PotatoSmile/custom-flightsim-control-panel-v1/photos/IMG_0789.jpg

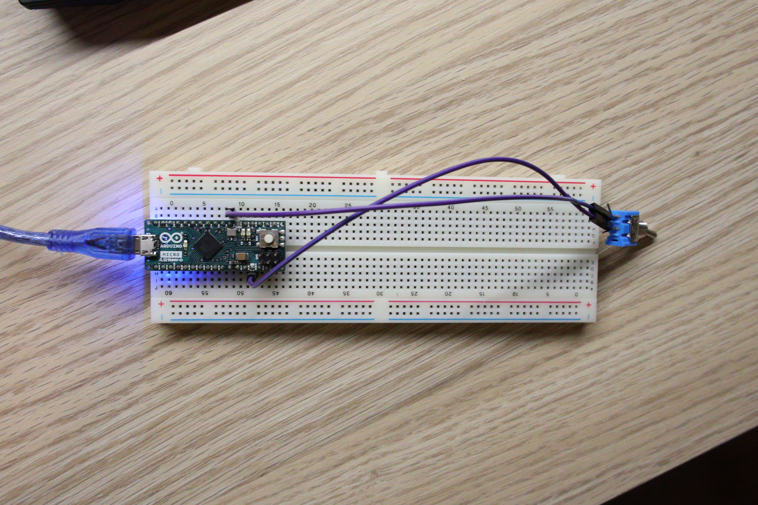
photos/IMG_0789.jpg
