PotatoSmile/custom-flightsim-control-panel-v1/photos/IMG_0802.jpg

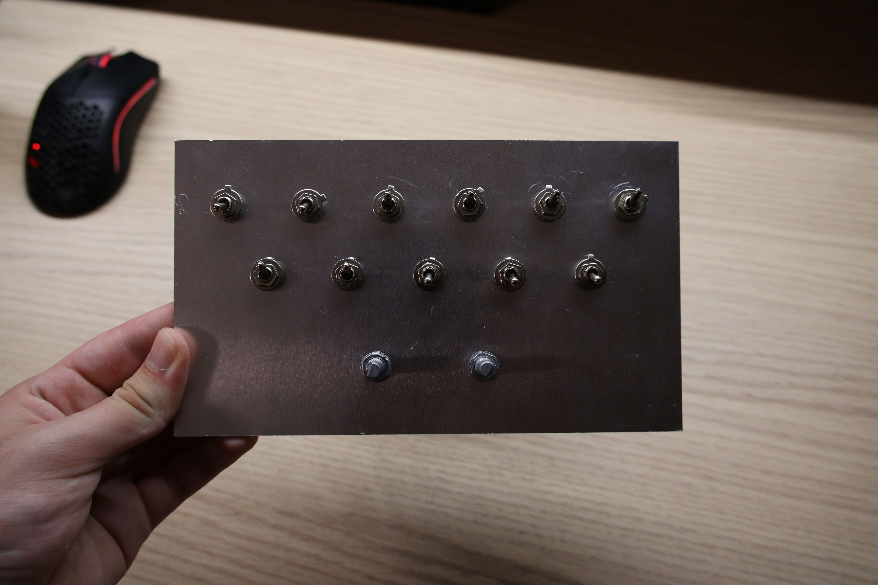
photos/IMG_0802.jpg
