PotatoSmile/custom-flightsim-control-panel-v1/README.md

# custom-flightsim-control-panel

DIY USB switch panel for DCS World, built on an Arduino Micro.
