PotatoSmile/custom-flightsim-control-panel-v1/photos/IMG_0787.jpg

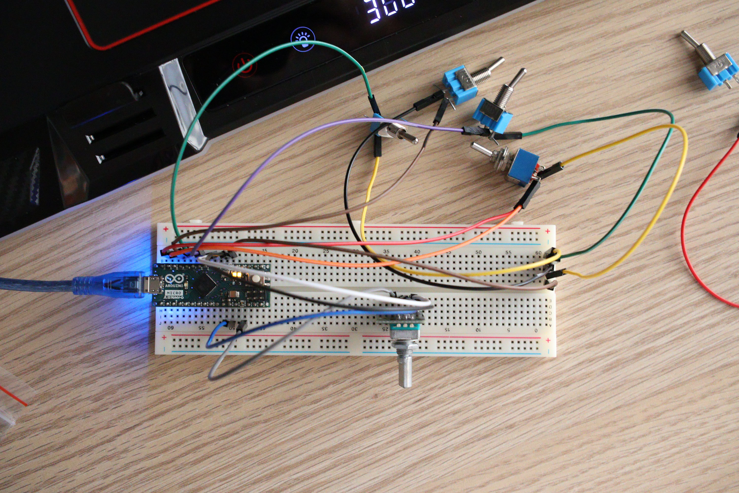
photos/IMG_0787.jpg
