PotatoSmile/custom-flightsim-control-panel-v1/photos/IMG_0793.jpg

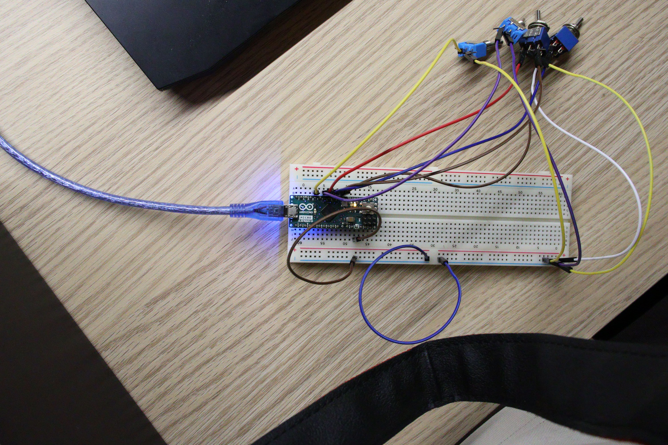
photos/IMG_0793.jpg
