PotatoSmile/custom-flightsim-control-panel-v1/photos/IMG_0794.jpg

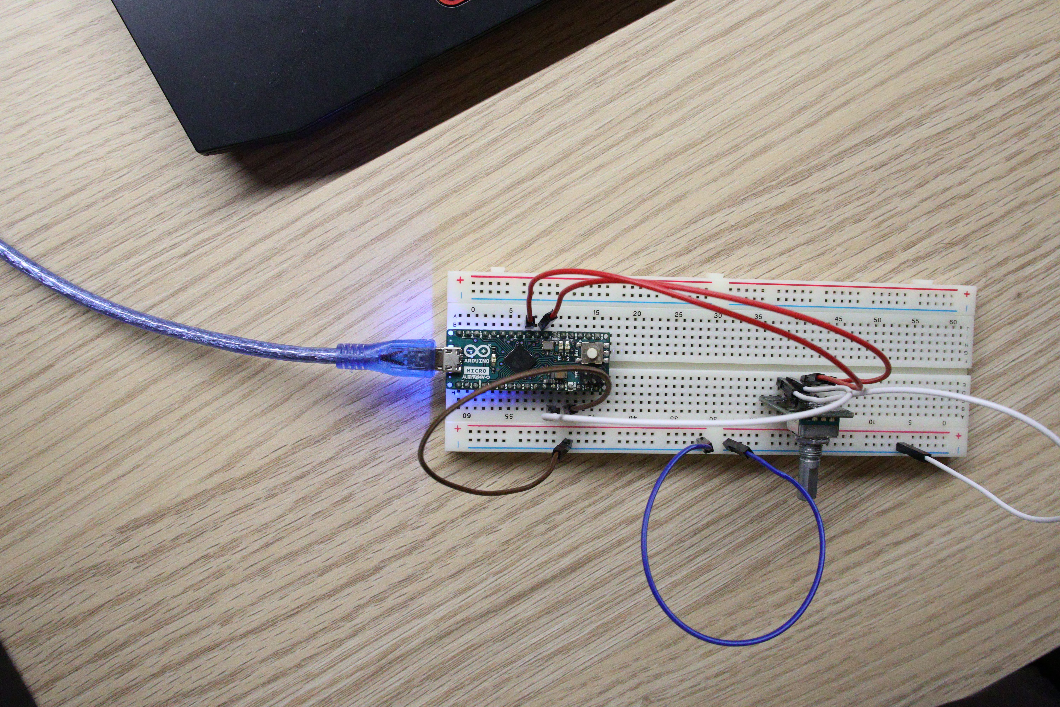
photos/IMG_0794.jpg
