PotatoSmile/custom-flightsim-control-panel-v1/photos/IMG_0796.jpg

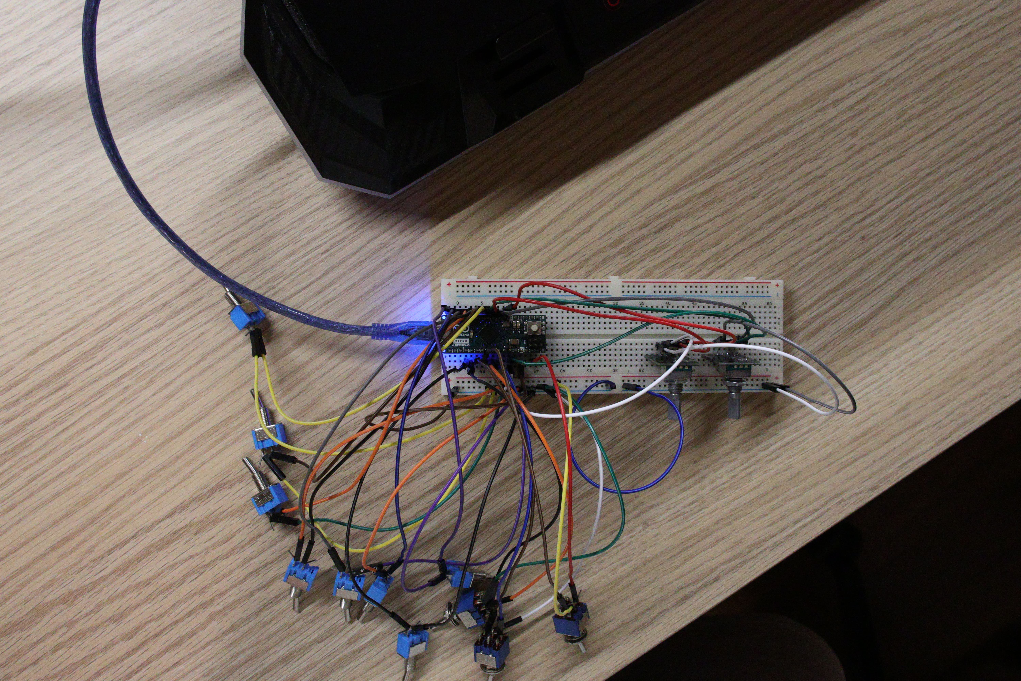
photos/IMG_0796.jpg
