PotatoSmile/custom-flightsim-control-panel-v1/photos/IMG_0798.jpg

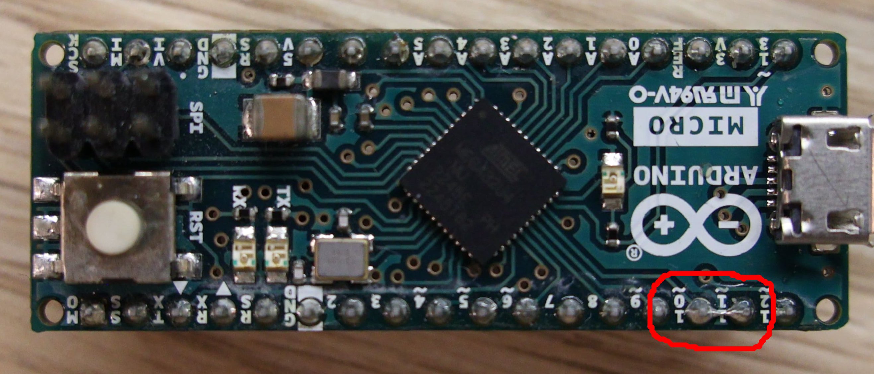
photos/IMG_0798.jpg
