PotatoSmile/custom-flightsim-control-panel-v1/photos/IMG_0799.jpg

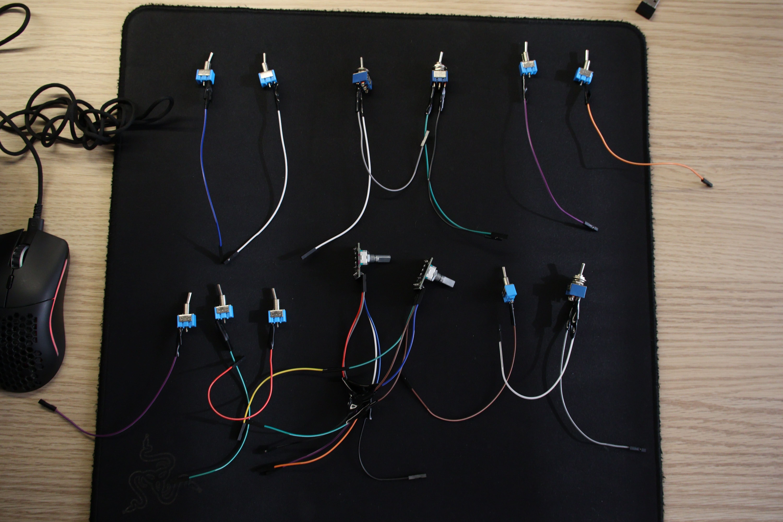
photos/IMG_0799.jpg
