PotatoSmile/custom-flightsim-control-panel-v1/photos/IMG_0801.jpg

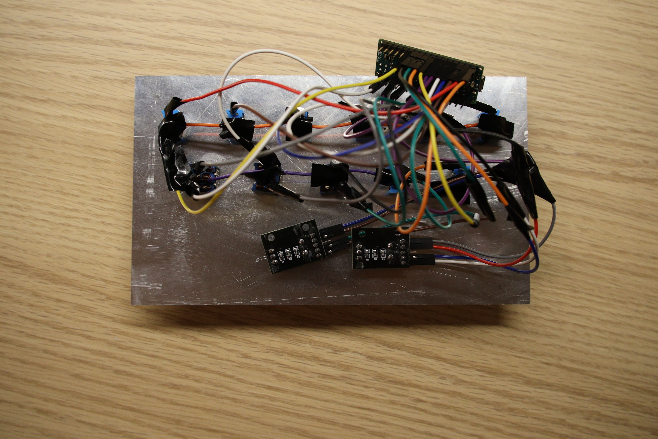
photos/IMG_0801.jpg
