PotatoSmile/custom-flightsim-control-panel-v1/hardware/panel.dxf

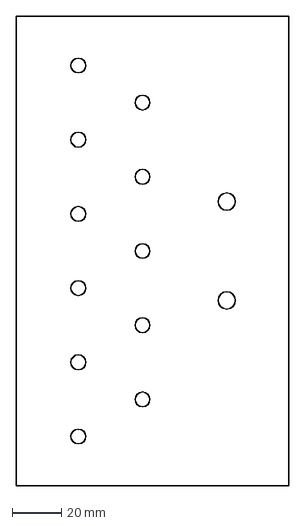
[picture p10: CAD file, 2026-10-01]
hardware/panel.dxf
110.0 x 190.0 mm
