PotatoSmile/custom-flightsim-control-panel-v1/(list of files, cad)

Other CAD files:
hardware/panel.f3d
