PotatoSmile/custom-flightsim-control-panel-v1/(list of files, drawings)

Other design files:
hardware/PCB Design.dsn
