PotatoSmile/custom-flightsim-control-panel-v1/(commit log)

2026-10-01 Initial project structure
    [panel.dxf, panel.f3d]
2026-10-10 Log soldering of all switch and encoder wiring
2026-10-14 Log panel arrival and switch mounting; unify build log format
2026-10-16 Log completed wiring and full input test
2026-11-01 Added images + PCB Design and production files
    [Flight Sim Control Panel V1.0-B_Cu.gbl, Flight Sim Control Panel V1.0-B_Mask.gbs, Flight Sim Control Panel V1.0-B_Paste.gbp, Flight Sim Control Panel V1.0-B_Silkscreen.gbo, Flight Sim Control Panel V1.0-Edge_Cuts.gm1, Flight Sim Control Panel V1.0-F_Cu.gtl, Flight Sim Control Panel V1.0-F_Mask.gts, Flight Sim Control Panel V1.0-F_Paste.gtp]
